Josh123likeme/Modular-Control-Interface/ProjectPhoto.jpeg

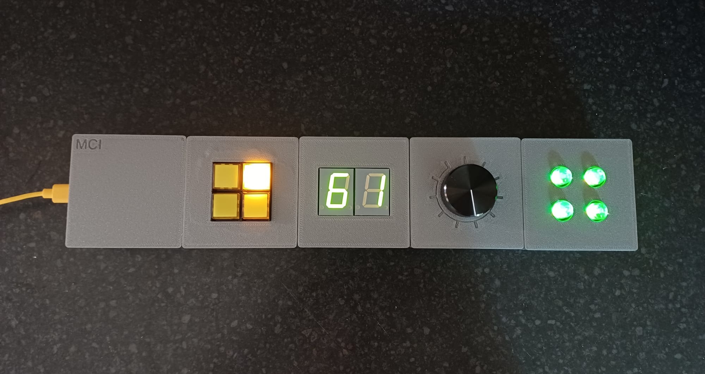
ProjectPhoto.jpeg
