Josh123likeme/Modular-Control-Interface/Obsidian/PART III Individual Project/Chips and Devices.md

## SIPO shift register (for module inputs)
https://assets.nexperia.com/documents/data-sheet/74HC_HCT595.pdf
Can take data in one bit a time serially and output the 8 bits in parallel
#### Operation
1) Keep MR high to prevent resetting
2) Keep OE low to allow output
3) Set STCP low to prevent storage register updating
4) Set SHCP low to initialise the clock
5) Set data bit on DS
6) Set SHCP high to clock data bit in
7) Set SHCP low to finish clock cycle
8) Repeat from step 5 until all 8 data bits have been shifted in
9) Set STCP high to clock data into storage register
10) Set STCP low to prevent storage register updating
11) Data can be shifted out of the device on Q7S to allow daisy chaining

## PISO shift register (for module outputs)
https://assets.nexperia.com/documents/data-sheet/74HC_HCT165.pdf
Can take a 8 bit parallel input and put it into the shift register to send the data serially

#### Operation
1) Keep CE low to enable shifting
2) Set PL high to prevent data immediately entering shift registers
3) Set CP low to initialise the clock
4) Set 8 bits of data on D0-D7.
5) Set PL low to move data into shift registers
6) Set PL high to prevent data changing in the shift registers
7) Set CP high to shift the shift register contents
8) Set CP low to finish clock cycle
9) Repeat from step 7 until all 8 bits have been sent serially
10) Data can be shifted into the device on DS to allow daisy chaining
## Quad 2-input multiplexer (For device discovery identifier)
https://assets.nexperia.com/documents/data-sheet/74HC_HCT157.pdf
Use two of these to switch between device discovery mode and operational mode
## Absolute rotary encoder
https://www.mouser.co.uk/datasheet/3/40/1/ace.pdf
Use part number: EAW0J-B24-AE0128L

- 0-360 degree rotation
- anti-rotation lug position at 9:00
- 128 encoded positions (grey coded)
- Needs a cap
- Constant 8-bit parallel absolute rotation output
## Magnetic connectors
https://www.aliexpress.com/item/1005005284441979.html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
## Push buttons
https://www.aliexpress.com/item/1005005791728074.html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
