Josh123likeme/Modular-Control-Interface/Module internal layout.pptx

Tin

8-bit serial-parallel register

Tout

Set

7:0

Device

7:0

Discovery identifier

7:0

Clk

2 Quad 2-input multiplexers

Mode

Rout

7:0

Enable

8-bit parallel-serial register

Rin
