Josh123likeme/Modular-Control-Interface/Fusion360 files/Controller module/USB cable bracket.step

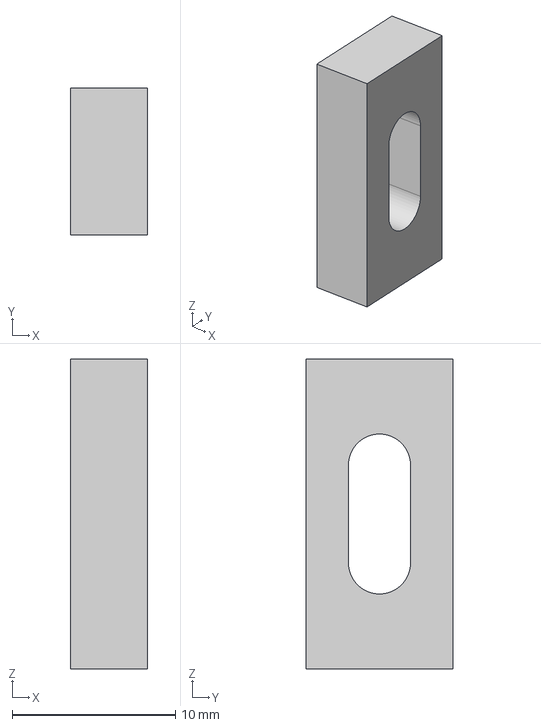
[picture p2: CAD file, 2026-08-01]
Fusion360 files/Controller module/USB cable bracket.step
4.70 x 9.00 x 19.0 mm
