Josh123likeme/Modular-Control-Interface/Fusion360 files/Pogo pin connector.step

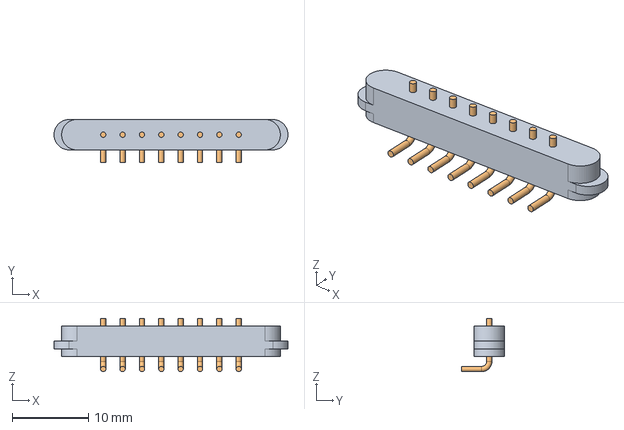
[picture p3: CAD file, 2026-08-01]
Fusion360 files/Pogo pin connector.step
30.7 x 5.65 x 7.00 mm
