Josh123likeme/Modular-Control-Interface/Fusion360 files/Quad button/Quad button top.step

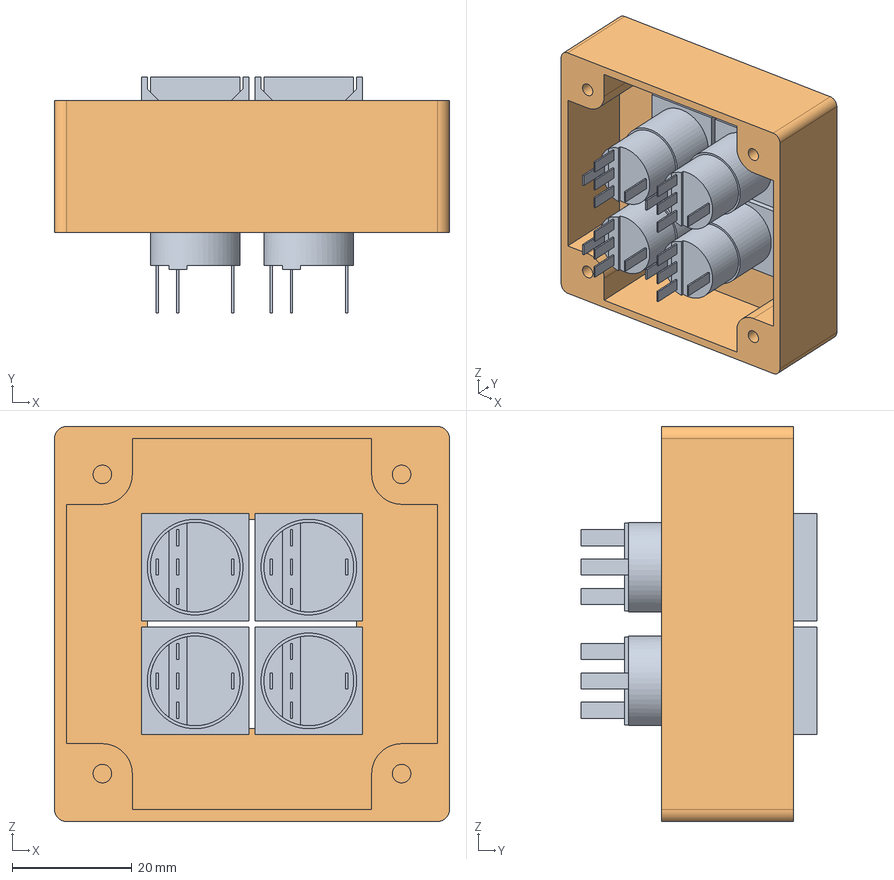
[picture p4: CAD file, 2026-08-01]
Fusion360 files/Quad button/Quad button top.step
66.0 x 39.5 x 66.0 mm
