Josh123likeme/Modular-Control-Interface/Fusion360 files/Quad light/Quad light top.step

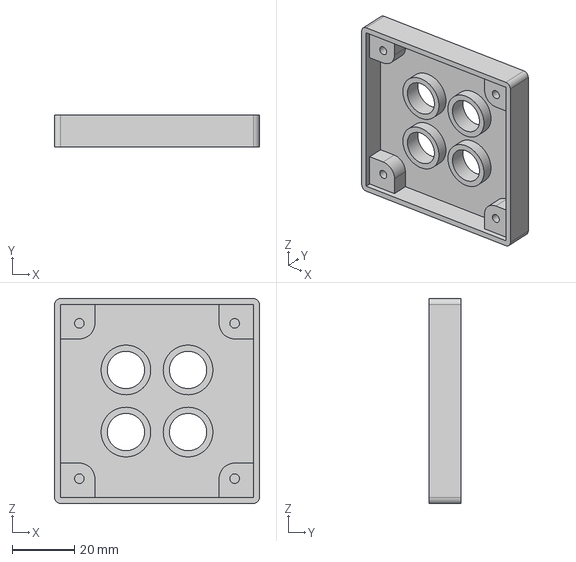
[picture p5: CAD file, 2026-08-01]
Fusion360 files/Quad light/Quad light top.step
66.0 x 10.2 x 66.0 mm
