Josh123likeme/Modular-Control-Interface/Fusion360 files/Seven segment/Seven segment top spacer.step

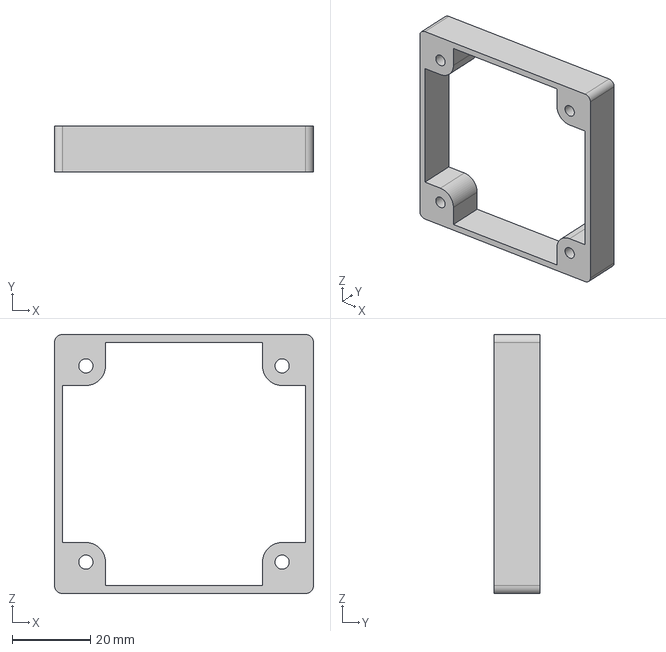
[picture p6: CAD file, 2026-08-01]
Fusion360 files/Seven segment/Seven segment top spacer.step
66.0 x 11.8 x 66.0 mm
