Josh123likeme/Modular-Control-Interface/Fusion360 files/Single knob/Adaptor.step

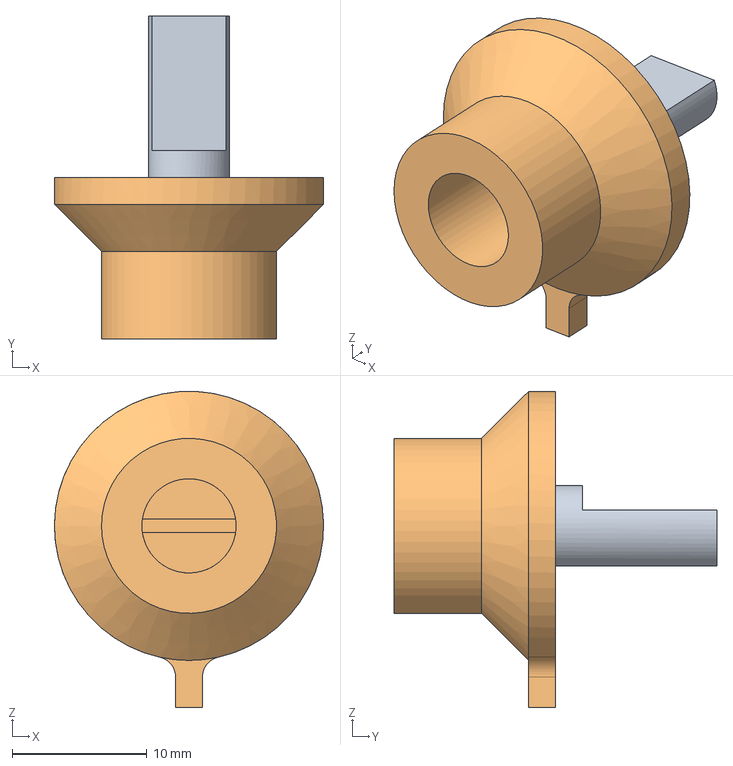
[picture p7: CAD file, 2026-08-01]
Fusion360 files/Single knob/Adaptor.step
20.0 x 24.0 x 23.5 mm
