Josh123likeme/Modular-Control-Interface/Fusion360 files/Controller module/Controller module top.step

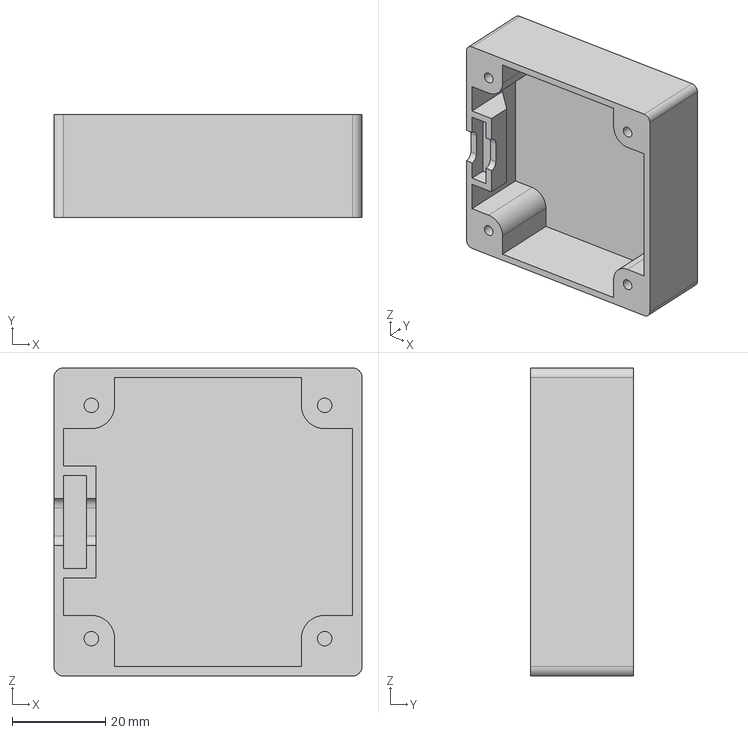
[picture p8: CAD file, 2026-08-01]
Fusion360 files/Controller module/Controller module top.step
66.0 x 22.0 x 66.0 mm
