Josh123likeme/Modular-Control-Interface/Fusion360 files/Module bottom.step

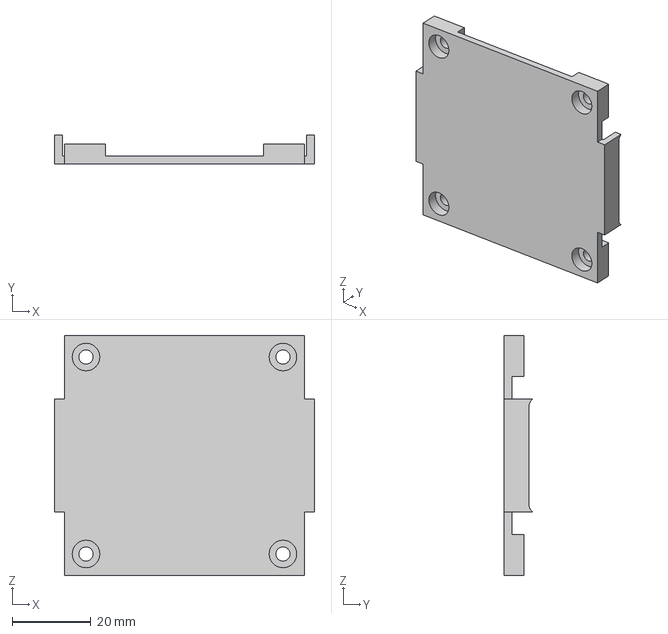
[picture p9: CAD file, 2026-08-01]
Fusion360 files/Module bottom.step
66.0 x 7.30 x 61.0 mm
