Josh123likeme/Modular-Control-Interface/Fusion360 files/Quad button/Button.step

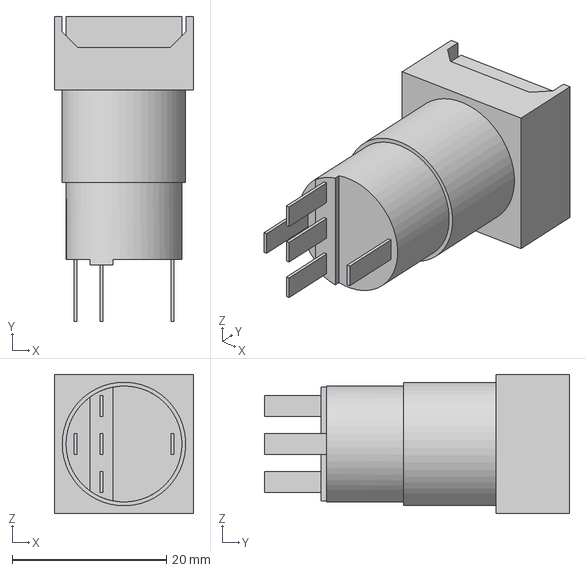
[picture p10: CAD file, 2026-08-01]
Fusion360 files/Quad button/Button.step
18.0 x 39.5 x 18.0 mm
