Josh123likeme/Modular-Control-Interface/Fusion360 files/Seven segment/Seven segment display PCB.step

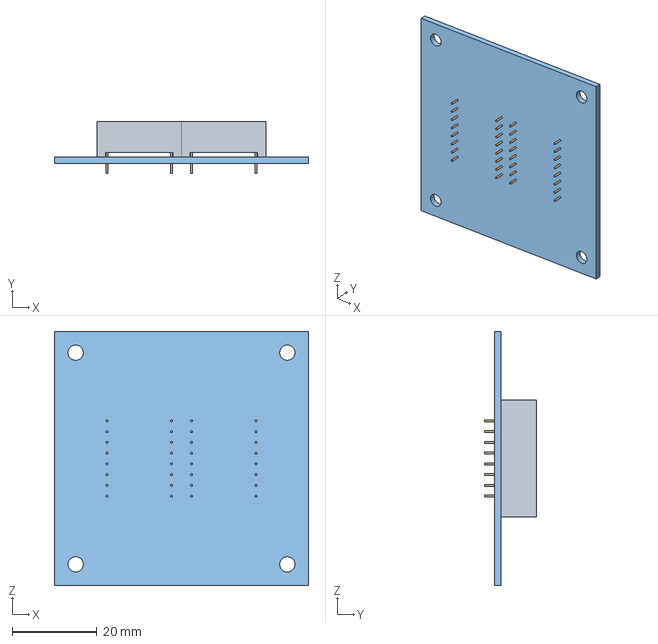
[picture p11: CAD file, 2026-08-01]
Fusion360 files/Seven segment/Seven segment display PCB.step
60.0 x 12.4 x 60.0 mm
