Josh123likeme/Modular-Control-Interface/Fusion360 files/Single knob/Rotary encoder.step

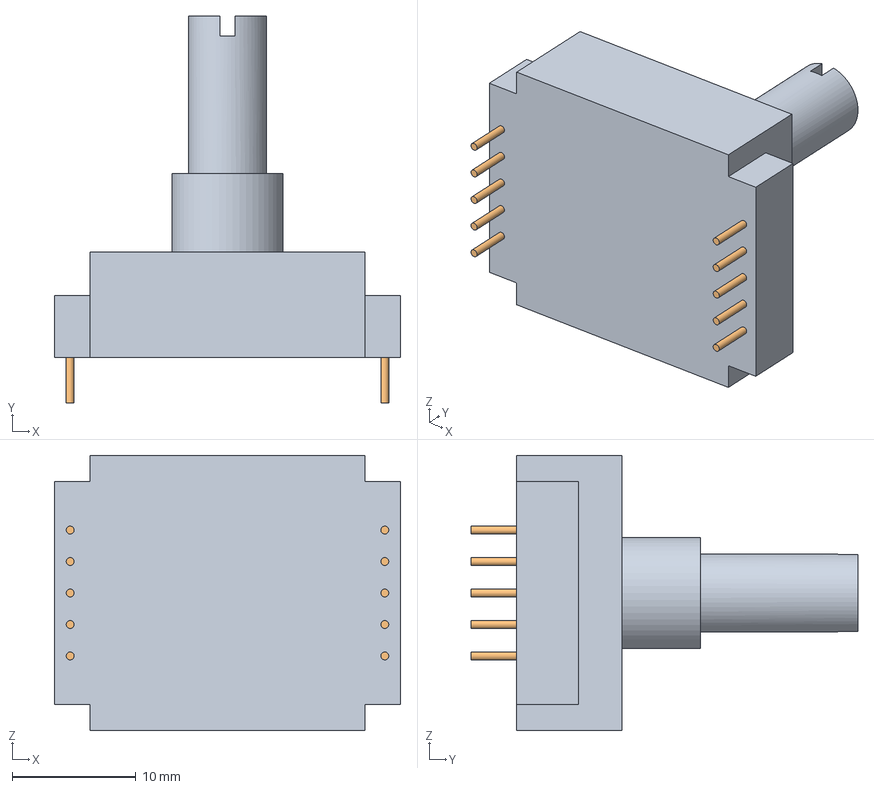
[picture p12: CAD file, 2026-08-01]
Fusion360 files/Single knob/Rotary encoder.step
27.9 x 31.2 x 22.2 mm
