Josh123likeme/Modular-Control-Interface/Fusion360 files/Controller module/Controller module bottom.step

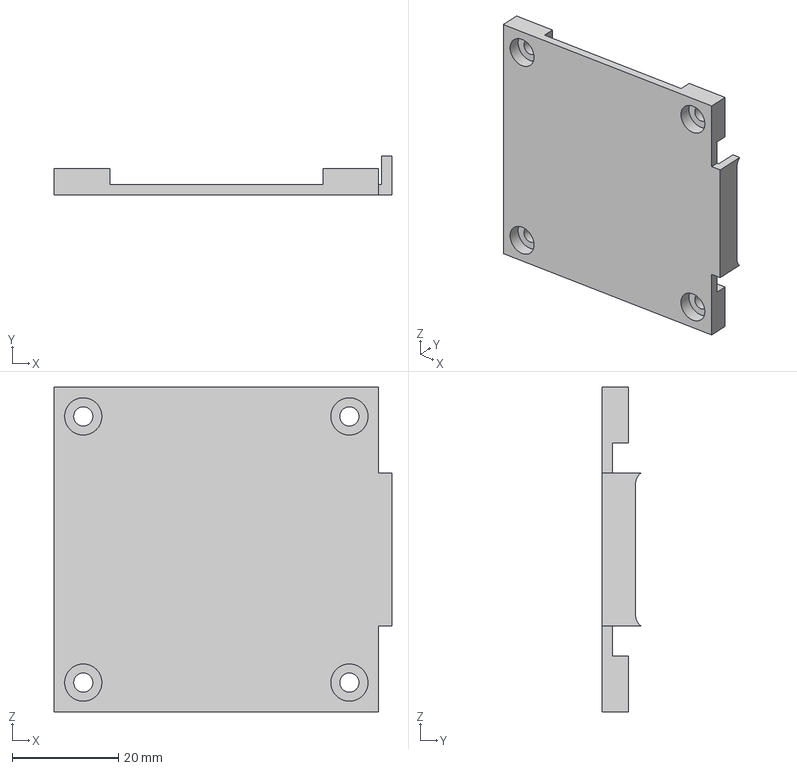
[picture p13: CAD file, 2026-08-01]
Fusion360 files/Controller module/Controller module bottom.step
63.5 x 7.30 x 61.0 mm
