Josh123likeme/Modular-Control-Interface/Fusion360 files/Module middle.step

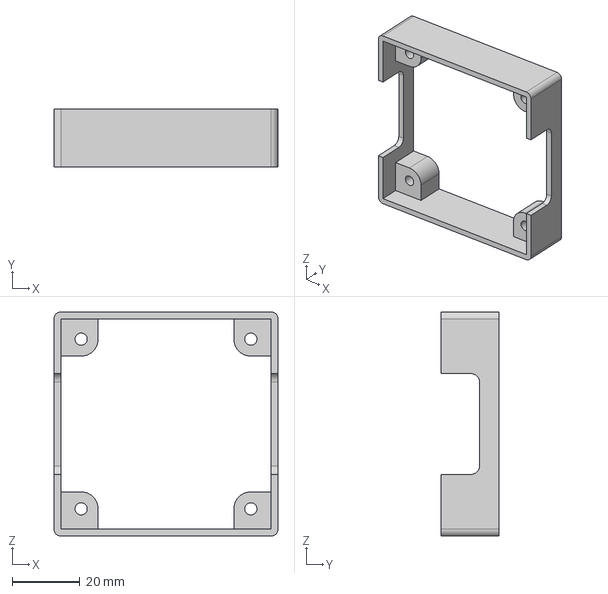
[picture p14: CAD file, 2026-08-01]
Fusion360 files/Module middle.step
66.0 x 17.0 x 66.0 mm
