Josh123likeme/Modular-Control-Interface/Fusion360 files/Seven segment/Seven segment display.step

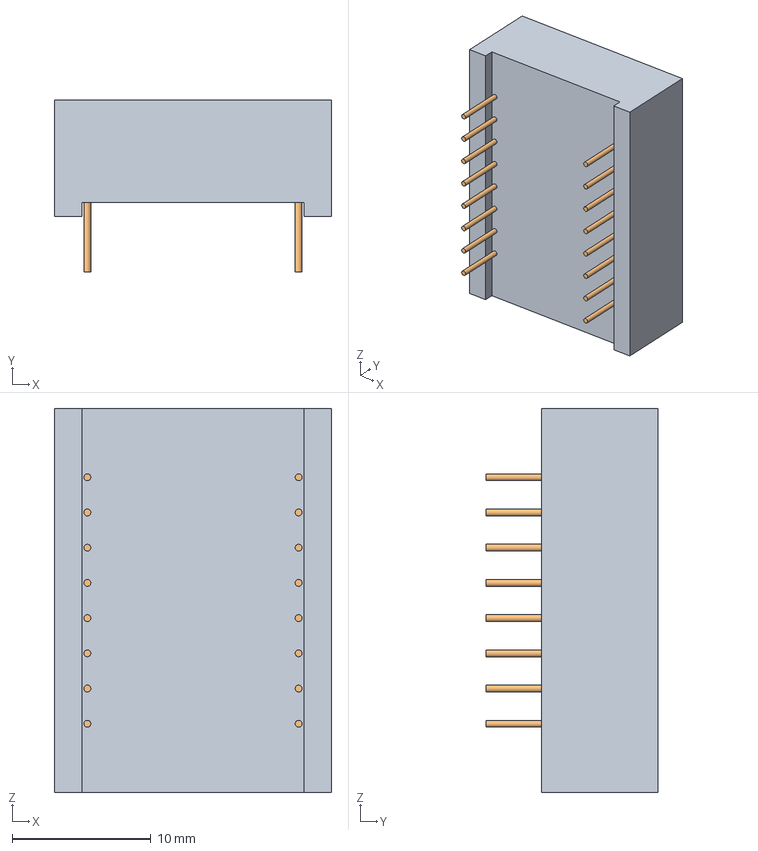
[picture p15: CAD file, 2026-08-01]
Fusion360 files/Seven segment/Seven segment display.step
20.0 x 12.4 x 27.7 mm
