Josh123likeme/Modular-Control-Interface/Fusion360 files/Controller module/Controller module middle.step

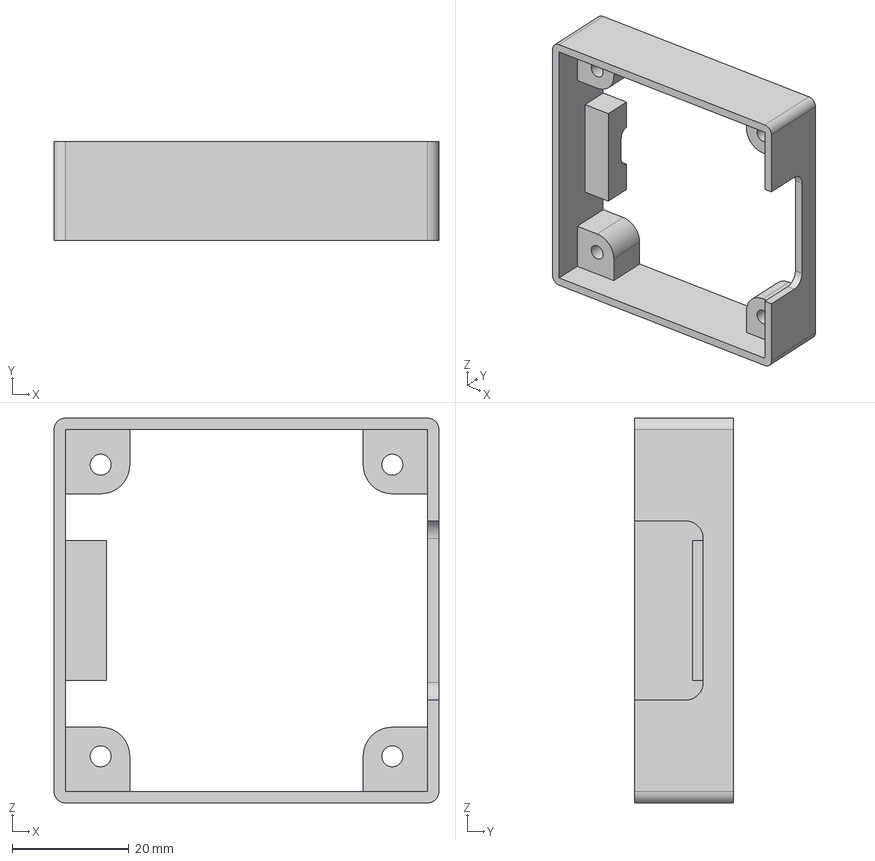
[picture p16: CAD file, 2026-08-01]
Fusion360 files/Controller module/Controller module middle.step
66.0 x 17.0 x 66.0 mm
