Josh123likeme/Modular-Control-Interface/Fusion360 files/PCB.step

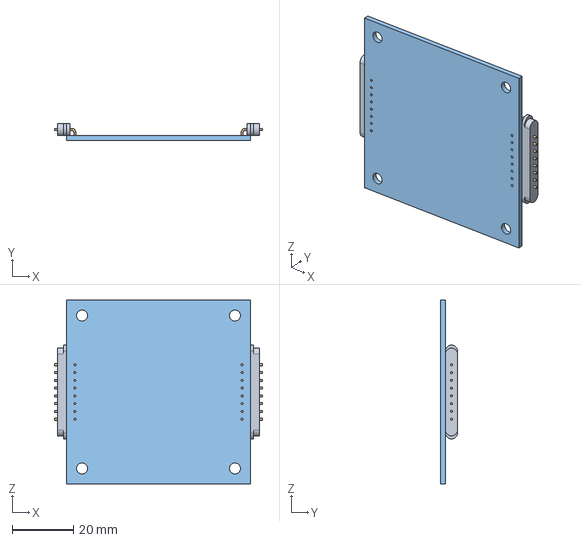
[picture p17: CAD file, 2026-08-01]
Fusion360 files/PCB.step
68.0 x 5.65 x 60.0 mm
