Josh123likeme/Modular-Control-Interface/Fusion360 files/Seven segment/Seven segment top.step

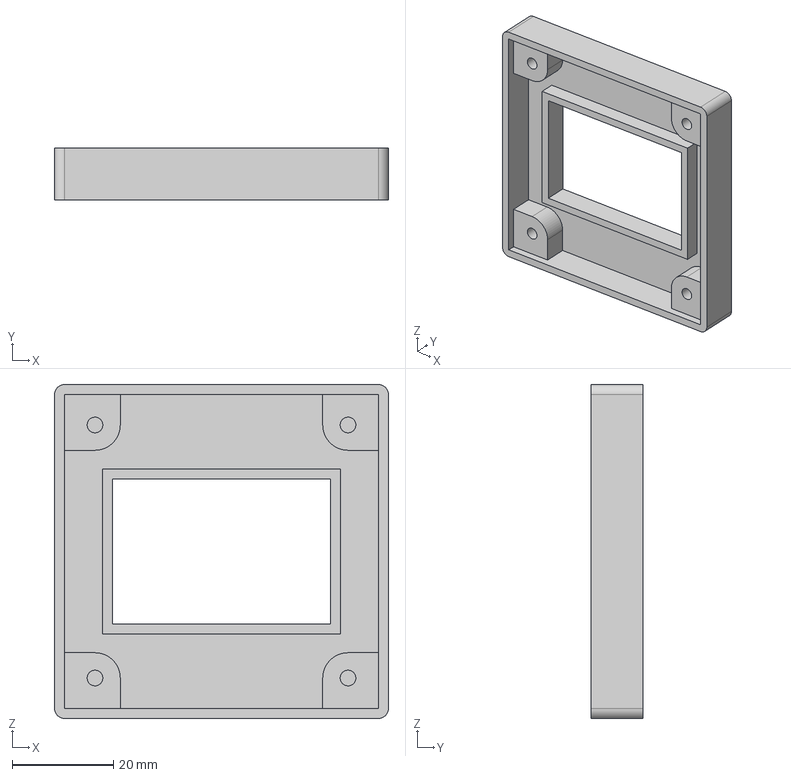
[picture p18: CAD file, 2026-08-01]
Fusion360 files/Seven segment/Seven segment top.step
66.0 x 10.2 x 66.0 mm
