Josh123likeme/Modular-Control-Interface/(list of files, cad)

Other CAD files:
Fusion360 files/PARAMETERS.step
