Josh123likeme/Modular-Control-Interface/PCBs/Part III Individual Project/Part III Individual Project.kicad_pcb

## KiCad design PCBs/Part III Individual Project/Part III Individual Project.kicad_pcb (2026-08-01)

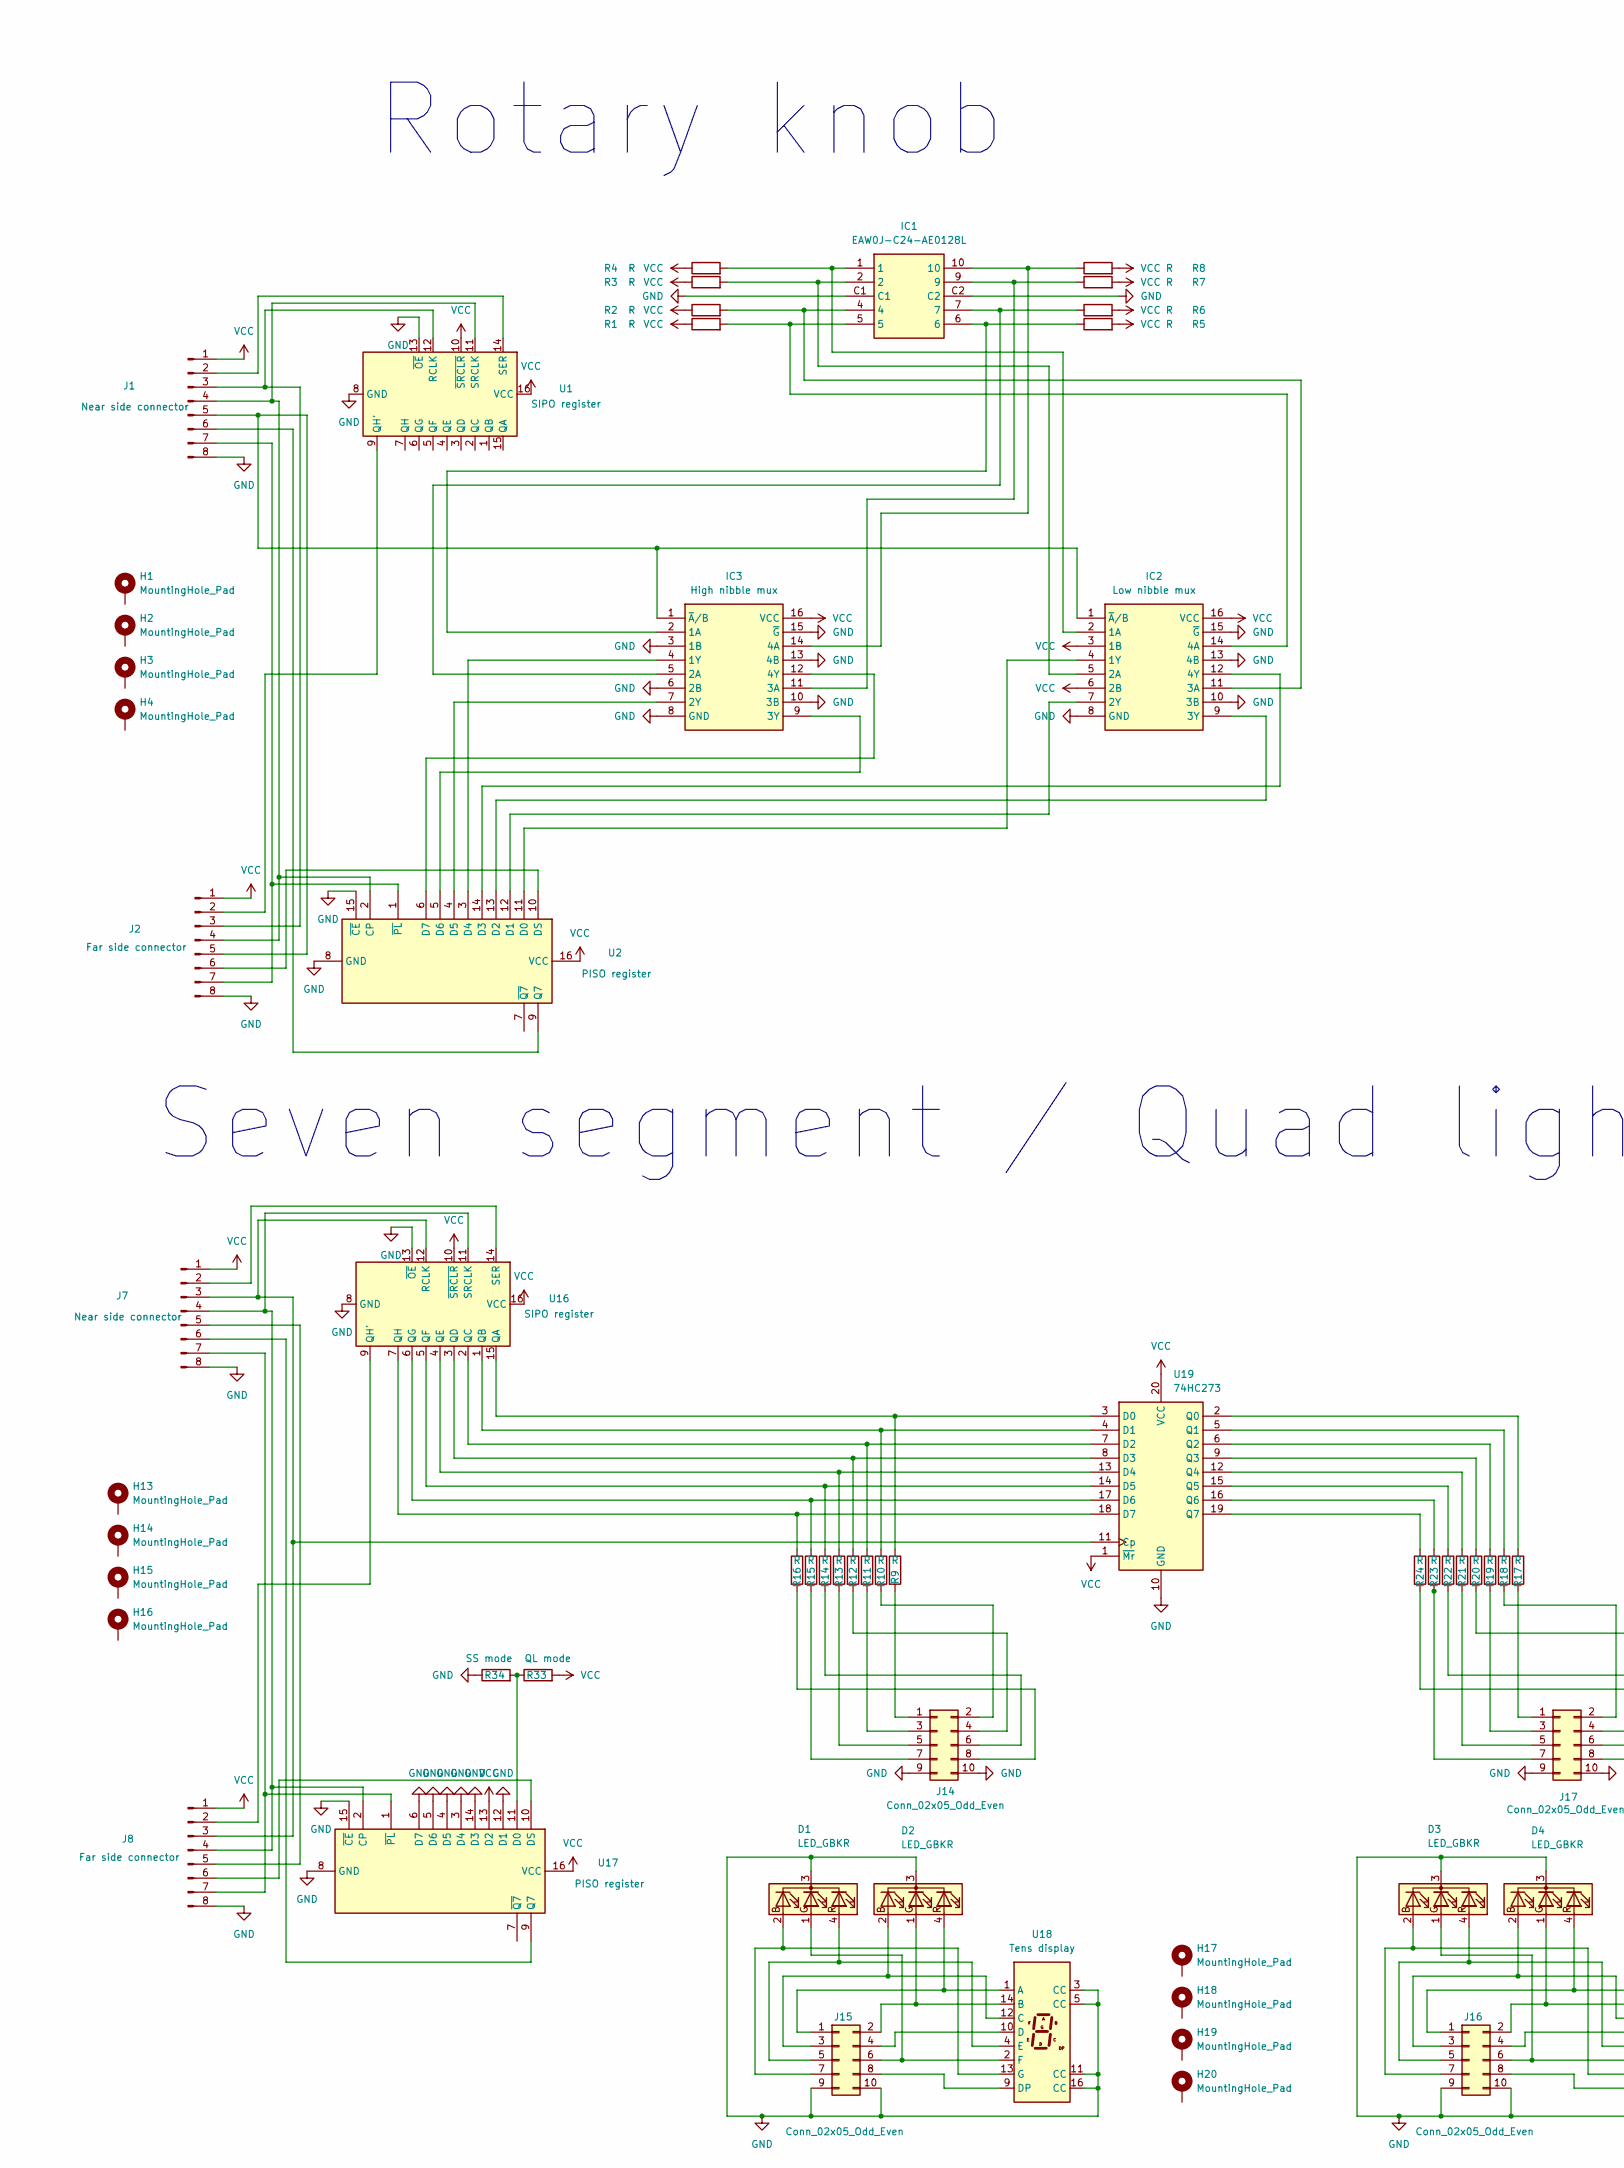
[picture p19: schematic Part III Individual Project.kicad_sch, part in row 1, column 1]

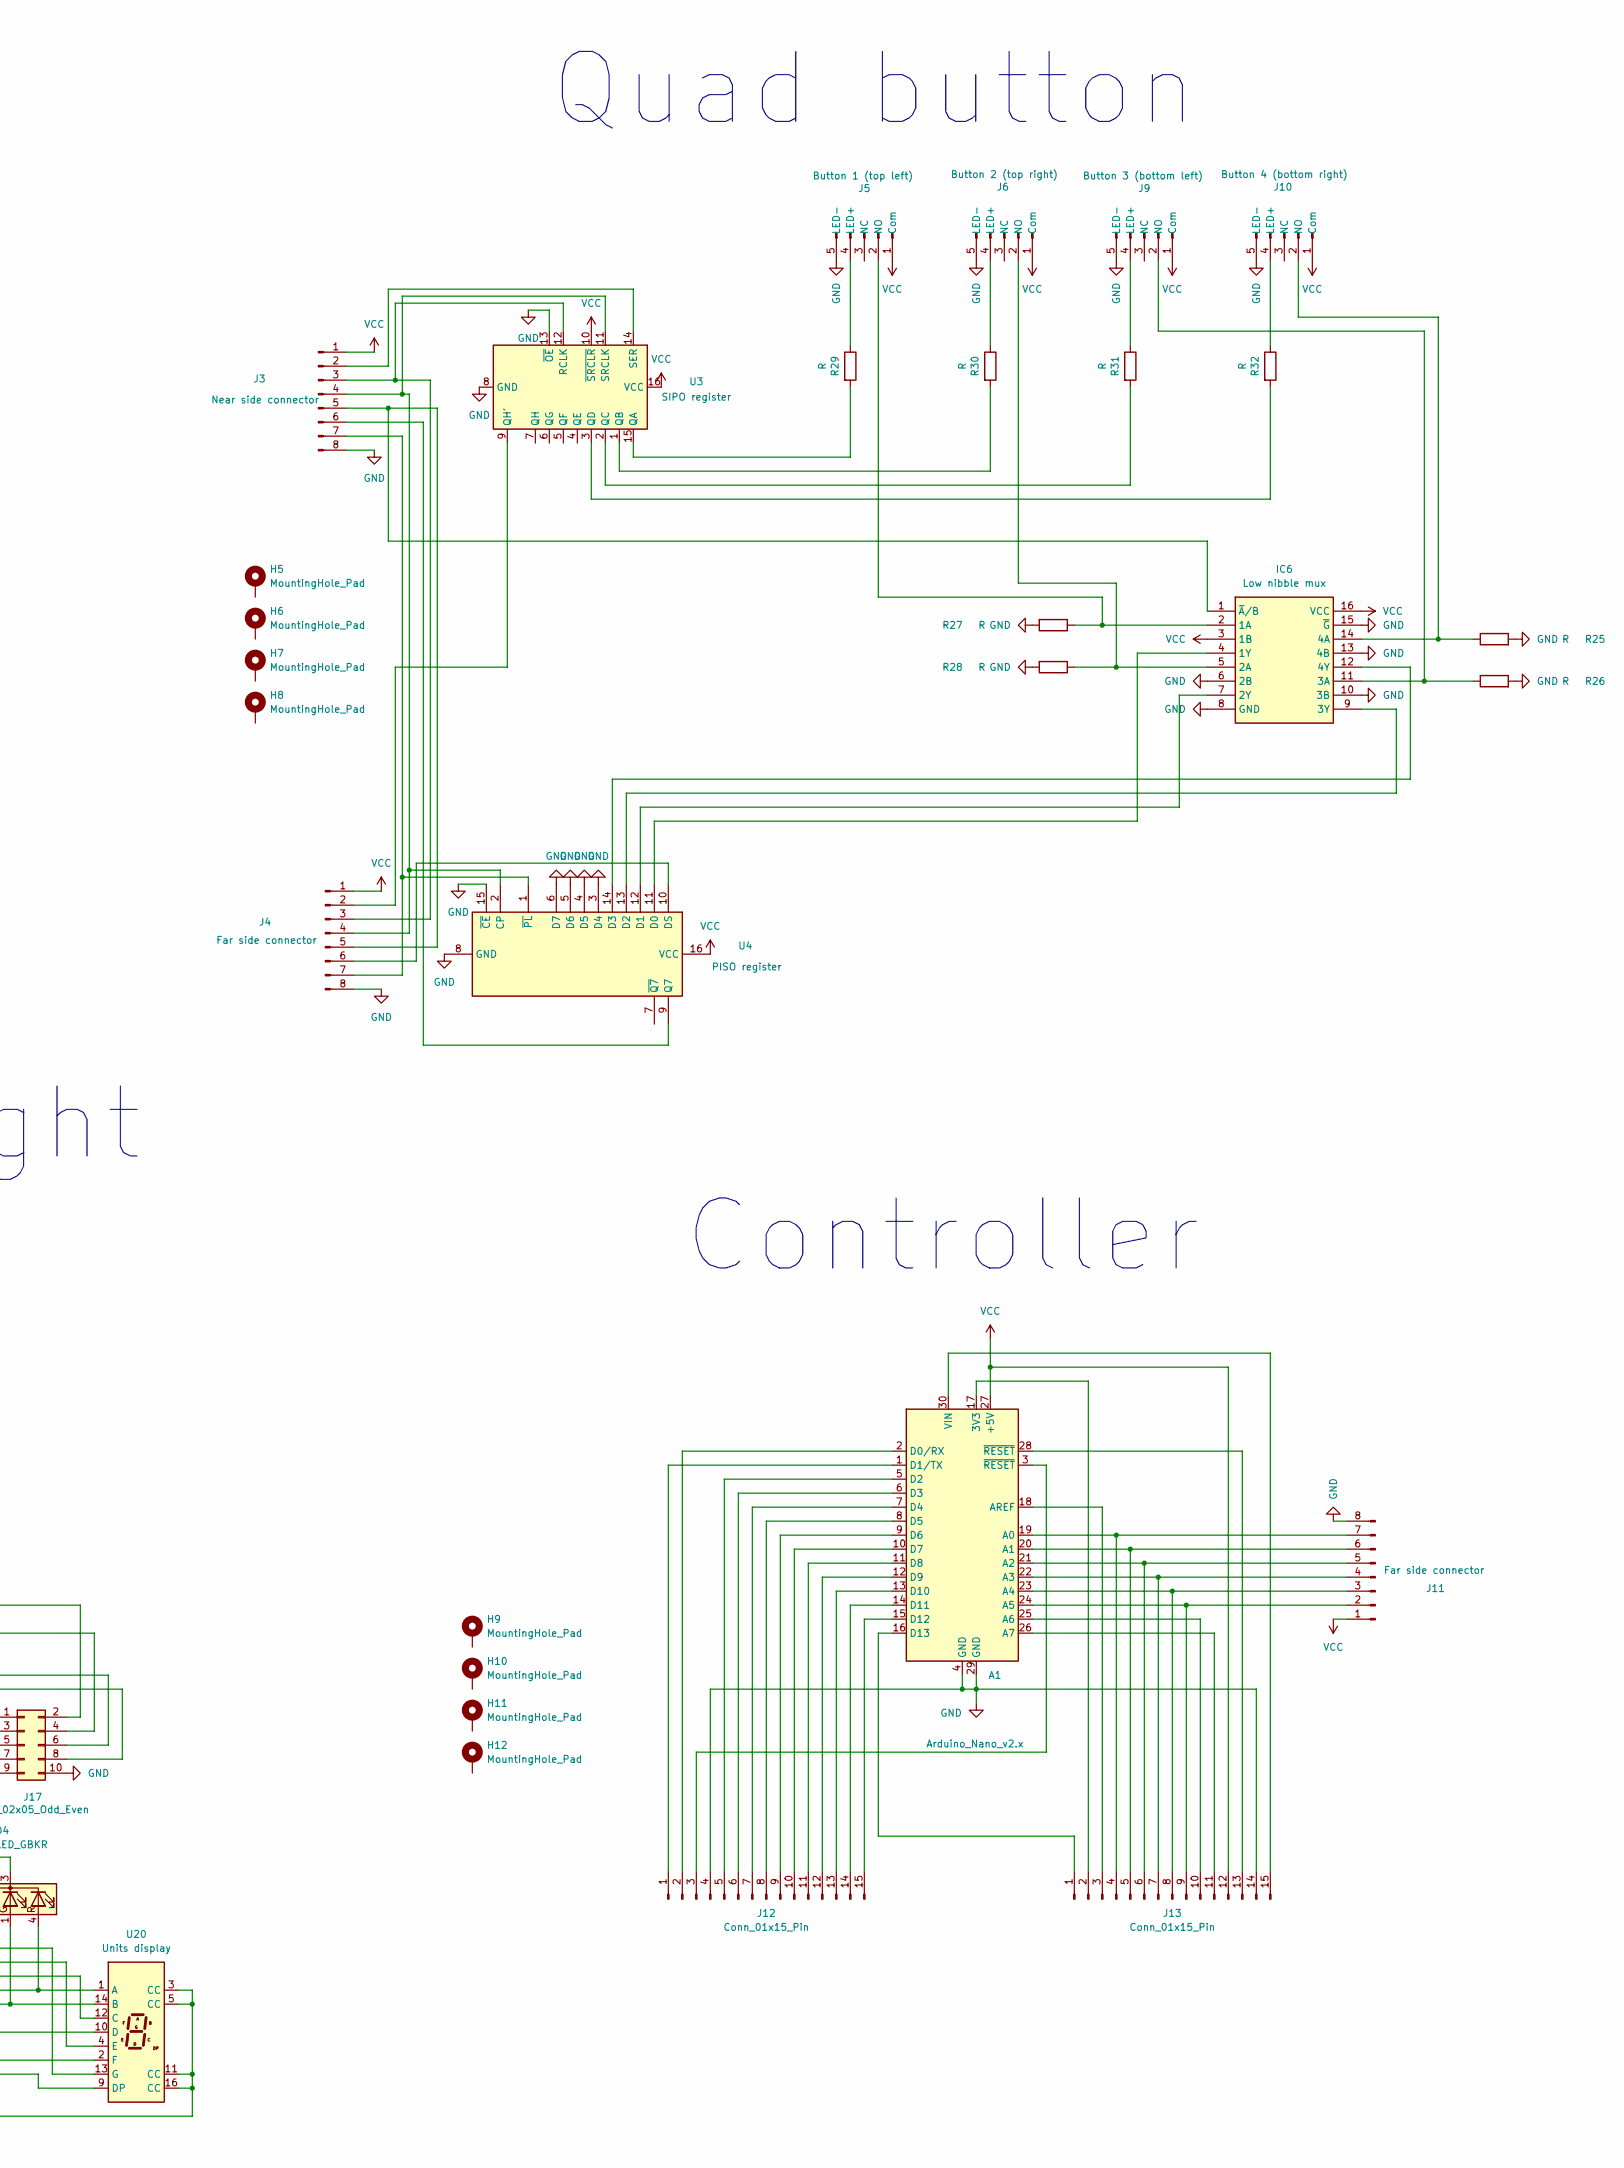
[picture p20: schematic Part III Individual Project.kicad_sch, part in row 1, column 2]

Parts:
A1: Arduino_Nano_v2.x; Arduino Nano ATMEGA328P Headers Face Down
D1, D2, D3, D4: LED_GBKR; LED_D5.0mm-4_RGB_Wide_Pins
H1, H2, H3, H4, H5, H6, H7, H8, H9, H10, H11, H12, H13, H14, H15, H16, H17, H18, H19, H20: MountingHole_Pad; MountingHole_3.2mm_M3_Pad_Via
IC1: EAW0J-C24-AE0128L; EAW0JC24AE0128L; Mouser Part Number 652-EAW0J-C24-AEL
IC2, IC6: Low nibble mux; SOIC-16_3.9x9.9mm_P1.27mm; Mouser Part Number 595-SN74HC157DBR
IC3: High nibble mux; SOIC-16_3.9x9.9mm_P1.27mm; Mouser Part Number 595-SN74HC157DBR
J1, J3, J7: Near side connector; 8-way connector Pitch 2.54mm Lead Width 0.7mm
J2, J4, J8, J11: Far side connector; 8-way connector Pitch 2.54mm Lead Width 0.7mm
J5: Button 1 (top left); 16mm push button 5 pin 1NO 1NC
J6: Button 2 (top right); 16mm push button 5 pin 1NO 1NC
J9: Button 3 (bottom left); 16mm push button 5 pin 1NO 1NC
J10: Button 4 (bottom right); 16mm push button 5 pin 1NO 1NC
J12, J13: Conn_01x15_Pin; PinHeader_1x15_P2.54mm_Vertical
J14, J15, J16, J17: Conn_02x05_Odd_Even; PinHeader_2x05_P2.54mm_Vertical
R1, R2, R3, R4, R5, R6, R7, R8, R9, R10, R11, R12, R13, R14, R15, R16, R17, R18, R19, R20, R21, R22, R23, R24, R25, R26, R27, R28, R29, R30, R31, R32: R; R_0805_2012Metric_Pad1.20x1.40mm_HandSolder
R33: QL mode; R_0805_2012Metric_Pad1.20x1.40mm_HandSolder
R34: SS mode; R_0805_2012Metric_Pad1.20x1.40mm_HandSolder
U1, U3, U16: SIPO register; SOIC-16_3.9x9.9mm_P1.27mm
U2, U4, U17: PISO register; SOIC-16_3.9x9.9mm_P1.27mm
U18: Tens display; SC08-11GWA headers
U19: 74HC273; SOIC-20W_7.5x12.8mm_P1.27mm
U20: Units display; SC08-11GWA headers

Connections:
GND: A1.4 (GND), A1.29 (GND), D1.3 (K), D2.3 (K), D3.3 (K), D4.3 (K), IC1.C1, IC1.C2, IC2.8 (GND), IC2.10 (3B), IC2.13 (4B), IC2.15 (~G), IC3.3 (1B), IC3.6 (2B), IC3.8 (GND), IC3.10 (3B), IC3.13 (4B), IC3.15 (~G), IC6.6 (2B), IC6.8 (GND), IC6.10 (3B), IC6.13 (4B), IC6.15 (~G), J1.8, J2.8, J3.8, J4.8, J5.5 (LED-), J6.5 (LED-), J7.8, J8.8, J9.5 (LED-), J10.5 (LED-), J11.8, J12.4, J13.14, J14.9, J14.10, J15.9, J15.10, J16.9, J16.10, J17.9, J17.10, R25.2, R26.2, R27.2, R28.2, R34.1, U1.8 (GND), U1.13 (~OE), U2.8 (GND), U2.15 (~CE), U3.8 (GND), U3.13 (~OE), U4.3 (D4), U4.4 (D5), U4.5 (D6), U4.6 (D7), U4.8 (GND), U4.15 (~CE), U16.8 (GND), U16.13 (~OE), U17.3 (D4), U17.4 (D5), U17.5 (D6), U17.6 (D7), U17.8 (GND), U17.12 (D1), U17.14 (D3), U17.15 (~CE), U18.3 (CC), U18.5 (CC), U18.11 (CC), U18.16 (CC), U19.10 (GND), U20.3 (CC), U20.5 (CC), U20.11 (CC), U20.16 (CC)
unnamed: A1.17 (3V3), J13.2
unnamed: A1.19 (A0), J11.7, J13.4
unnamed: A1.20 (A1), J11.6, J13.5
unnamed: A1.21 (A2), J11.5, J13.6
unnamed: A1.22 (A3), J11.4, J13.7
unnamed: A1.23 (A4), J11.3, J13.8
unnamed: A1.24 (A5), J11.2, J13.9
unnamed: A1.25 (A6), J13.10
unnamed: A1.26 (A7), J13.11
unnamed: A1.18 (AREF), J13.3
unnamed: A1.2 (D0/RX), J12.2
unnamed: A1.1 (D1/TX), J12.1
unnamed: A1.5 (D2), J12.5
unnamed: A1.6 (D3), J12.6
unnamed: A1.7 (D4), J12.7
unnamed: A1.8 (D5), J12.8
unnamed: A1.9 (D6), J12.9
unnamed: A1.10 (D7), J12.10
unnamed: A1.11 (D8), J12.11
unnamed: A1.12 (D9), J12.12
unnamed: A1.13 (D10), J12.13
unnamed: A1.14 (D11), J12.14
unnamed: A1.15 (D12), J12.15
unnamed: A1.16 (D13), J13.1
unnamed: A1.30 (VIN), J13.15
unnamed: D1.2 (BA), J15.7, U18.13 (G)
unnamed: D1.1 (GA), J15.6, U18.2 (F)
unnamed: D1.4 (RA), J15.5, U18.4 (E)
unnamed: D2.2 (BA), J15.3, U18.12 (C)
unnamed: D2.1 (GA), J15.2, U18.14 (B)
unnamed: D2.4 (RA), J15.1, U18.1 (A)
unnamed: D3.2 (BA), J16.7, U20.13 (G)
unnamed: D3.1 (GA), J16.6, U20.2 (F)
unnamed: D3.4 (RA), J16.5, U20.4 (E)
unnamed: D4.2 (BA), J16.3, U20.12 (C)
unnamed: D4.1 (GA), J16.2, U20.14 (B)
unnamed: D4.4 (RA), J16.1, U20.1 (A)
unnamed: IC1.1, IC2.2 (1A), R4.2
unnamed: IC2.4 (1Y), U2.11 (D0)
unnamed: IC1.2, IC2.5 (2A), R3.2
unnamed: IC2.7 (2Y), U2.12 (D1)
unnamed: IC1.4, IC2.11 (3A), R2.2
unnamed: IC2.9 (3Y), U2.13 (D2)
unnamed: IC1.5, IC2.14 (4A), R1.2
unnamed: IC2.12 (4Y), U2.14 (D3)
unnamed: IC2.1 (~A/B), IC3.1 (~A/B), J1.5, J2.5
unnamed: IC1.6, IC3.2 (1A), R5.1
unnamed: IC3.4 (1Y), U2.3 (D4)
unnamed: IC1.7, IC3.5 (2A), R6.1
unnamed: IC3.7 (2Y), U2.4 (D5)
unnamed: IC1.9, IC3.11 (3A), R7.1
unnamed: IC3.9 (3Y), U2.5 (D6)
unnamed: IC1.10, IC3.14 (4A), R8.1
unnamed: IC3.12 (4Y), U2.6 (D7)
unnamed: IC6.2 (1A), J5.2 (NO), R27.1
unnamed: IC6.4 (1Y), U4.11 (D0)
unnamed: IC6.5 (2A), J6.2 (NO), R28.1
unnamed: IC6.7 (2Y), U4.12 (D1)
unnamed: IC6.11 (3A), J9.2 (NO), R26.1
unnamed: IC6.9 (3Y), U4.13 (D2)
unnamed: IC6.14 (4A), J10.2 (NO), R25.1
unnamed: IC6.12 (4Y), U4.14 (D3)
unnamed: IC6.1 (~A/B), J3.5, J4.5
unnamed: J1.2, U1.14 (SER)
unnamed: J1.3, J2.3, U1.12 (RCLK)
unnamed: J1.4, J2.4, U1.11 (SRCLK), U2.2 (CP)
unnamed: J1.6, U2.9 (Q7)
unnamed: J1.7, J2.7, U2.1 (~PL)
unnamed: J2.2, U1.9 (QH')
unnamed: J2.6, U2.10 (DS)
unnamed: J3.2, U3.14 (SER)
unnamed: J3.3, J4.3, U3.12 (RCLK)
unnamed: J3.4, J4.4, U3.11 (SRCLK), U4.2 (CP)
unnamed: J3.6, U4.9 (Q7)
unnamed: J3.7, J4.7, U4.1 (~PL)
unnamed: J4.2, U3.9 (QH')
unnamed: J4.6, U4.10 (DS)
unnamed: J5.4 (LED+), R29.1
unnamed: J6.4 (LED+), R30.1
unnamed: J7.2, U16.14 (SER)
unnamed: J7.3, J8.3, U16.12 (RCLK), U19.11 (Cp)
unnamed: J7.4, J8.4, U16.11 (SRCLK), U17.2 (CP)
unnamed: J7.5, J8.5
unnamed: J7.6, U17.9 (Q7)
unnamed: J7.7, J8.7, U17.1 (~PL)
unnamed: J8.2, U16.9 (QH')
unnamed: J8.6, U17.10 (DS)
unnamed: J9.4 (LED+), R31.1
unnamed: J10.4 (LED+), R32.1
unnamed: A1.3 (~RESET), J12.3
unnamed: A1.28 (~RESET), J13.13
unnamed: J14.1, R9.2
unnamed: J14.2, R10.2
unnamed: J14.3, R11.2
unnamed: J14.4, R12.2
unnamed: J14.5, R13.2
unnamed: J14.6, R14.2
unnamed: J14.7, R15.2
unnamed: J14.8, R16.2
unnamed: J15.4, U18.10 (D)
unnamed: J15.8, U18.9 (DP)
unnamed: J16.4, U20.10 (D)
unnamed: J16.8, U20.9 (DP)
unnamed: J17.1, R17.2
unnamed: J17.2, R18.2
unnamed: J17.3, R19.2
unnamed: J17.4, R20.2
unnamed: J17.5, R21.2
unnamed: J17.6, R22.2
unnamed: J17.7, R23.2
unnamed: J17.8, R24.2
unnamed: R29.2, U3.15 (QA)
unnamed: R30.2, U3.1 (QB)
unnamed: R31.2, U3.2 (QC)
unnamed: R32.2, U3.3 (QD)
unnamed: R9.1, U16.15 (QA), U19.3 (D0)
unnamed: R10.1, U16.1 (QB), U19.4 (D1)
unnamed: R11.1, U16.2 (QC), U19.7 (D2)
unnamed: R12.1, U16.3 (QD), U19.8 (D3)
unnamed: R13.1, U16.4 (QE), U19.13 (D4)
unnamed: R14.1, U16.5 (QF), U19.14 (D5)
unnamed: R15.1, U16.6 (QG), U19.17 (D6)
unnamed: R16.1, U16.7 (QH), U19.18 (D7)
unnamed: R33.1, R34.2, U17.11 (D0)
unnamed: R17.1, U19.2 (Q0)
unnamed: R18.1, U19.5 (Q1)
unnamed: R19.1, U19.6 (Q2)
unnamed: R20.1, U19.9 (Q3)
unnamed: R21.1, U19.12 (Q4)
unnamed: R22.1, U19.15 (Q5)
unnamed: R23.1, U19.16 (Q6)
unnamed: R24.1, U19.19 (Q7)
VCC: A1.27 (+5V), IC2.3 (1B), IC2.6 (2B), IC2.16 (VCC), IC3.16 (VCC), IC6.3 (1B), IC6.16 (VCC), J1.1, J2.1, J3.1, J4.1, J5.1 (Com), J6.1 (Com), J7.1, J8.1, J9.1 (Com), J10.1 (Com), J11.1, J13.12, R1.1, R2.1, R3.1, R4.1, R5.2, R6.2, R7.2, R8.2, R33.2, U1.10 (~SRCLR), U1.16 (VCC), U2.16 (VCC), U3.10 (~SRCLR), U3.16 (VCC), U4.16 (VCC), U16.10 (~SRCLR), U16.16 (VCC), U17.13 (D2), U17.16 (VCC), U19.1 (~Mr), U19.20 (VCC)

Notes on the sheet:
Seven segment / Quad light
Controller
Rotary knob
Quad button

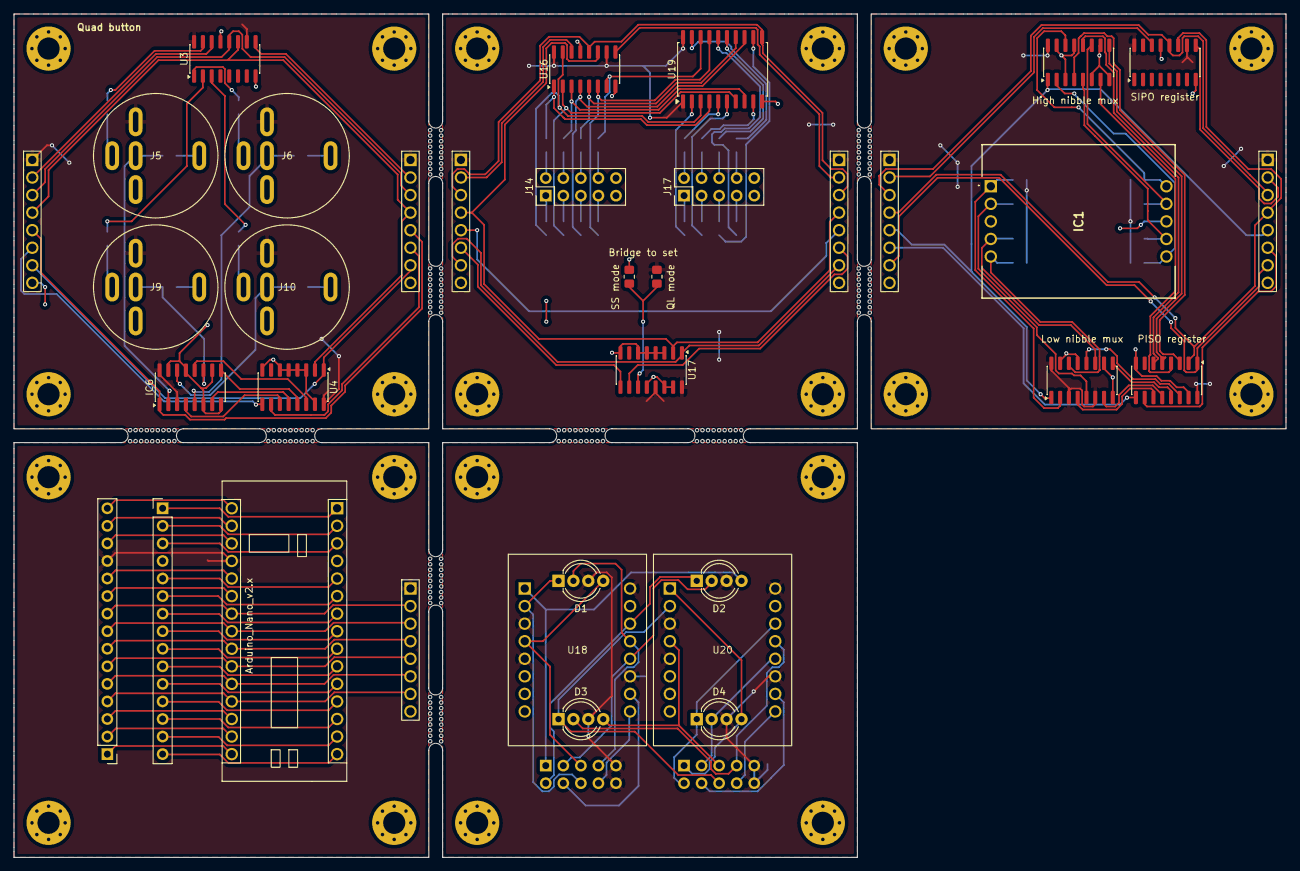
[picture p21: board Part III Individual Project.kicad_pcb from above]

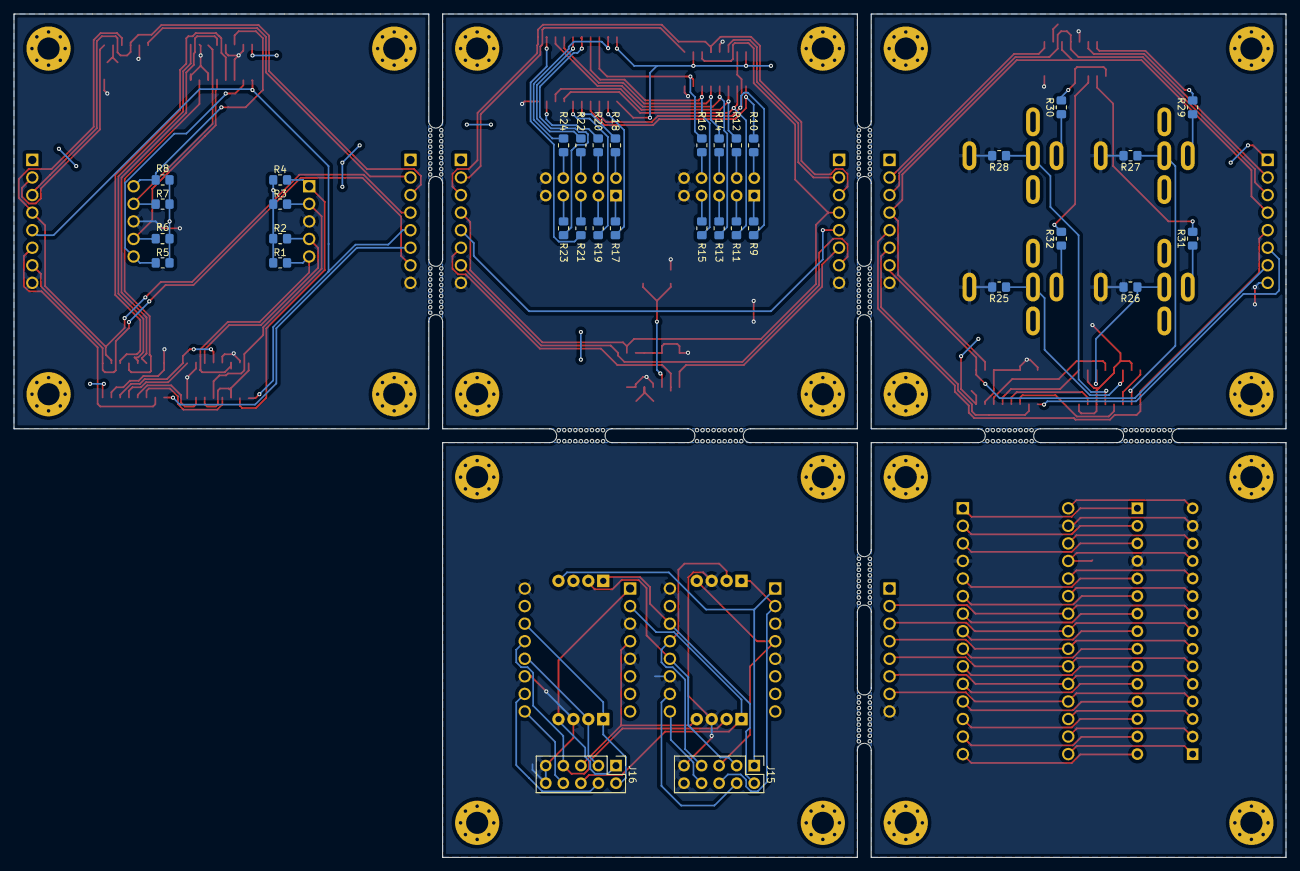
[picture p22: board Part III Individual Project.kicad_pcb from below]

Board: 2 copper layers, 184.0 x 122.0 mm, 99 parts (34 on the bottom side), 134 nets.

Other parts of the board:
mouse-bite-2mm-4mm, mouse-bite-2mm-4mm#2, mouse-bite-2mm-4mm#3, mouse-bite-2mm-4mm#4, mouse-bite-2mm-4mm#5, mouse-bite-2mm-4mm#6, mouse-bite-2mm-4mm#7, mouse-bite-2mm-4mm#8, mouse-bite-2mm-4mm#9, mouse-bite-2mm-4mm#10: VAL**; mouse_bite_2mm_7mm
